Tsjakka/WindowOpener/Photos/enclosure-design.jpg

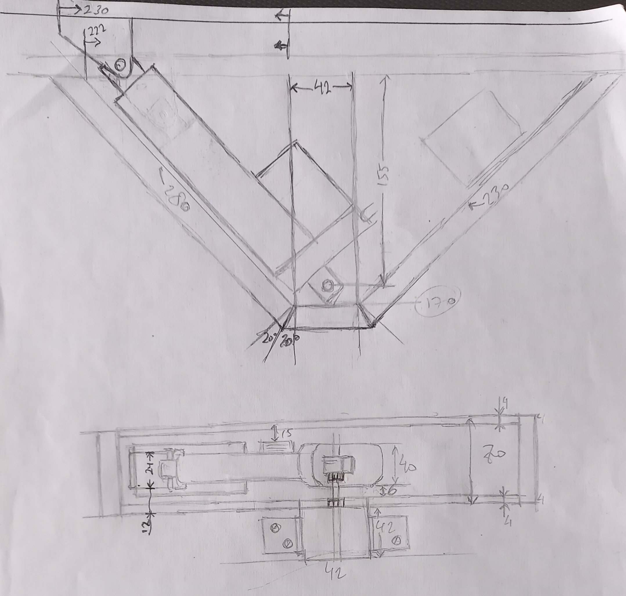
Photos/enclosure-design.jpg
