Tsjakka/WindowOpener/Photos/enclosure.jpg

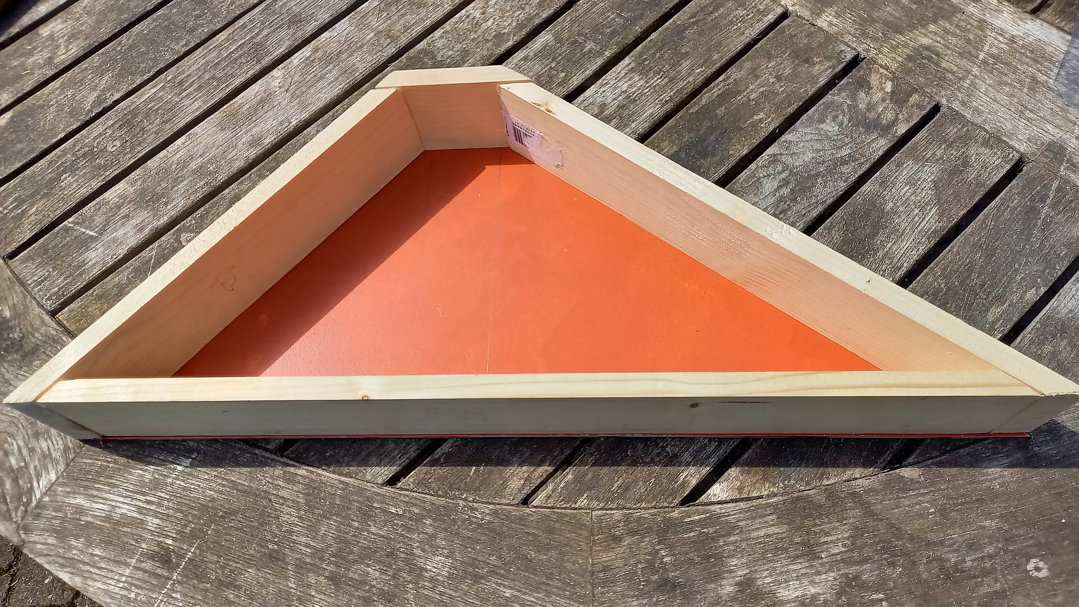
Photos/enclosure.jpg
