Tsjakka/WindowOpener/Photos/ESP8285.jpg

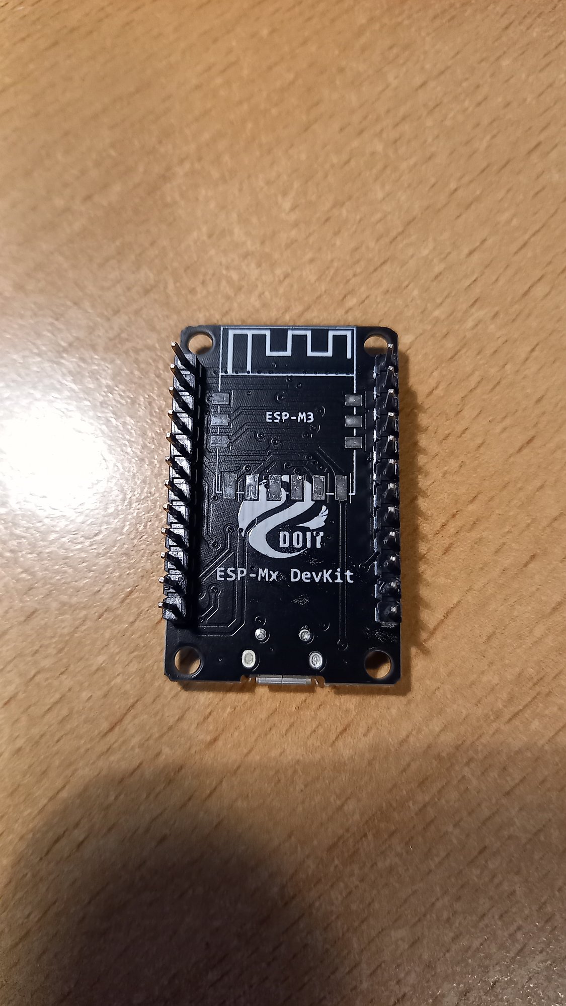
Photos/ESP8285.jpg
