Tsjakka/WindowOpener/Photos/final-product.jpg

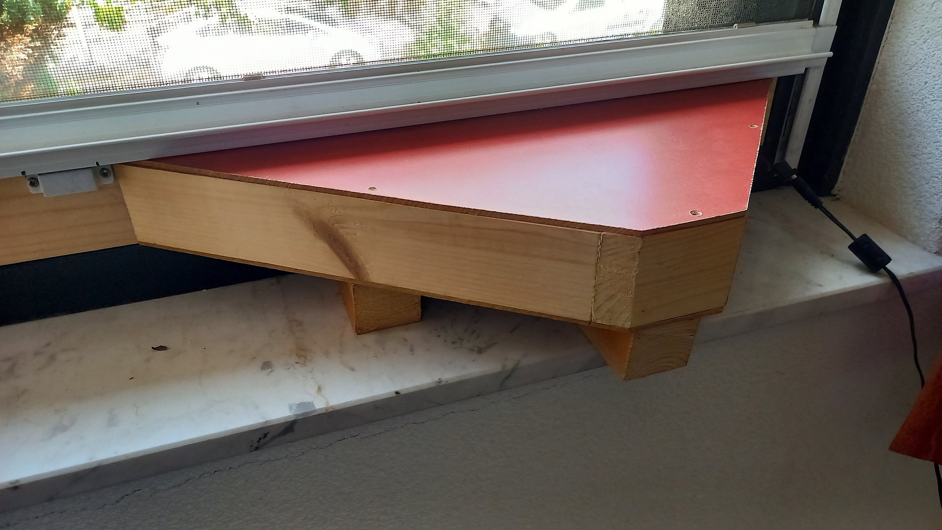
Photos/final-product.jpg
