Tsjakka/WindowOpener/Photos/linear-motor.jpg

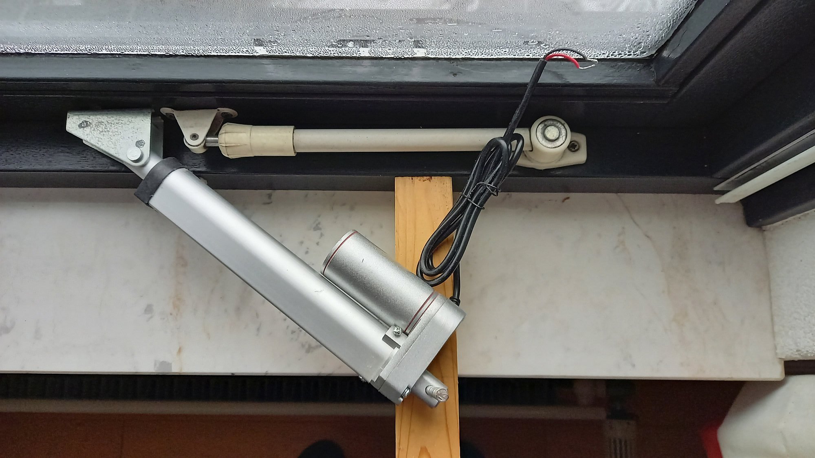
Photos/linear-motor.jpg
