Tsjakka/WindowOpener/Photos/StateTransitionDiagram.pdf

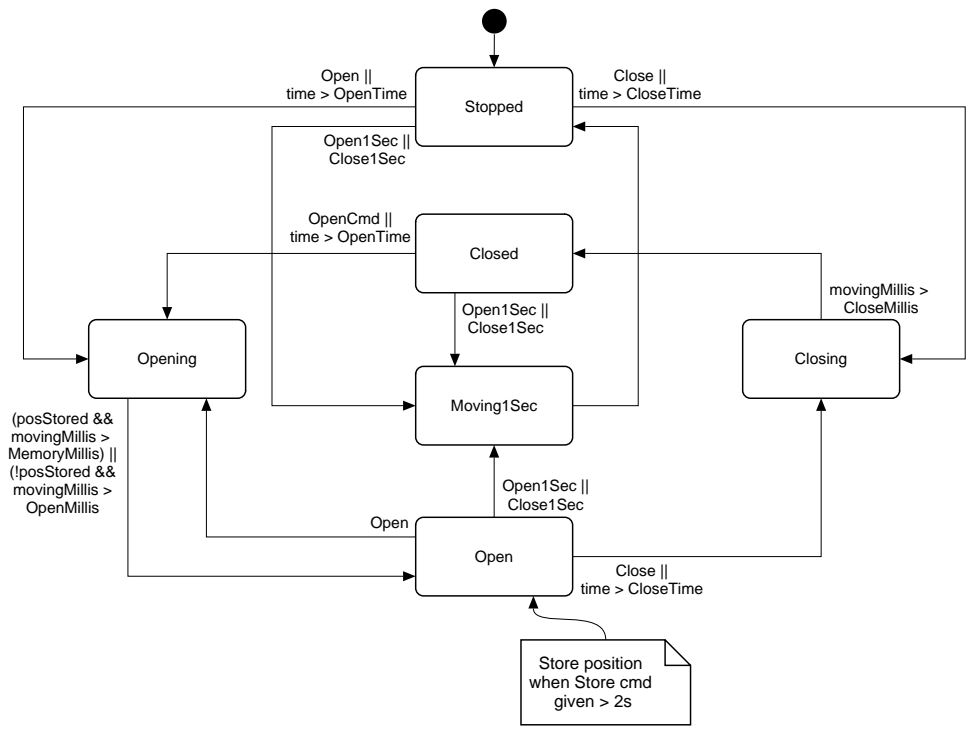
[picture p12: page 1]
Closed; Open; Opening; Closing; (posStored && movingMillis > MemoryMillis) || (!posStored && movingMillis > OpenMillis; movingMillis > CloseMillis; OpenCmd || time > OpenTime; Close || time > CloseTime; Stopped; Open || time > OpenTime; Moving1Sec; Open1Sec || Close1Sec

Store position
when Store cmd
given > 2s
