Tsjakka/WindowOpener/(commit log)

2023-07-30 Fixed problem in weekend days. Fixed problem in stopping at memory position. Added code to reset memory position. Updated state transition diagram.
    [WindowOpener.ino]
2023-07-30 Updated PCB-design.jpg.
2026-10-25 Switch to winter time at the right moment; DST is determined from the UTC moment and the weekly clock update moved to Sunday 3:30. Log memory reserved at startup and trimmed in place, so logging no l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
